whiskerpad/Machine_room_sip_phone/docs/schematic.png

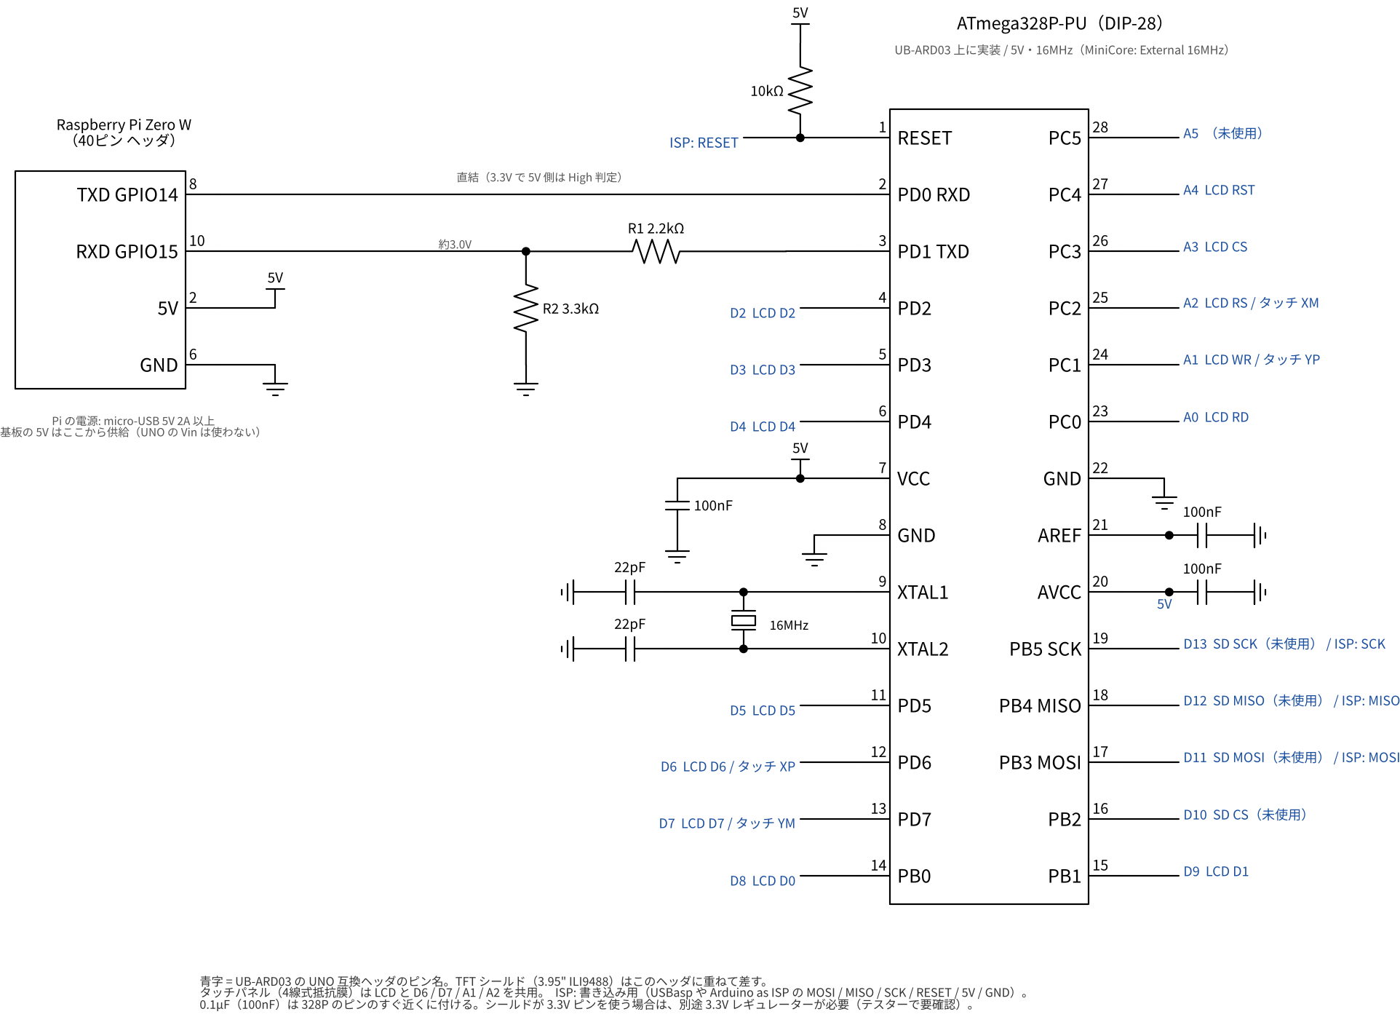
docs/schematic.png
