whiskerpad/Machine_room_sip_phone/(commit log)

2026-11-01 Initial commit: Pi Zero W SIP phone and server
    [kamailio.cfg]
2026-11-05 Add schematic, touch diagnostics, TFT renderer; update devlog and README
